MiSaKa100039/Ebike_Motor_Driver/doc/微信图片_2025-11-17_170304_445.png

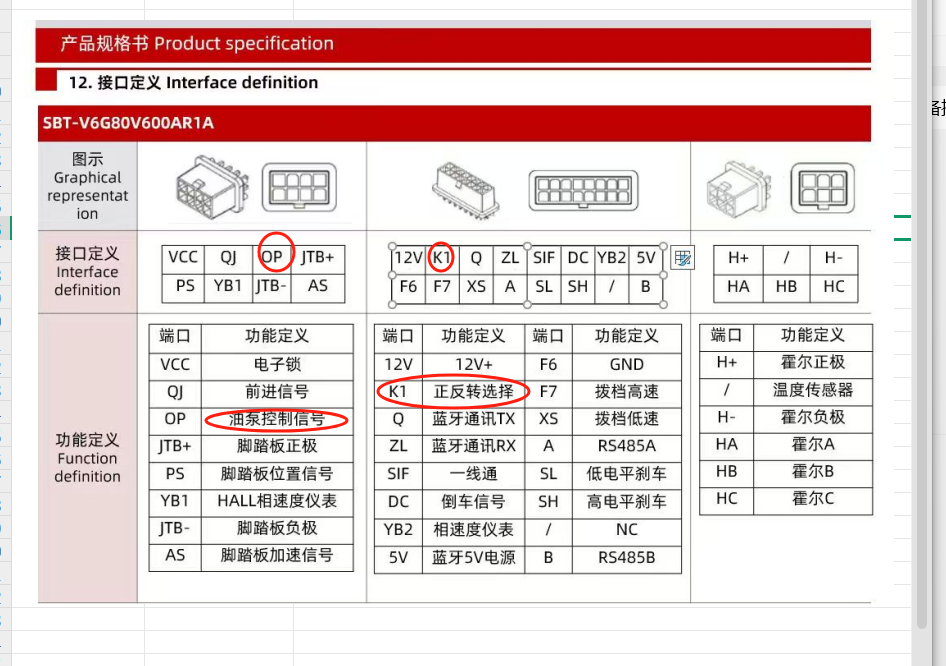
doc/微信图片_2025-11-17_170304_445.png
