MiSaKa100039/Ebike_Motor_Driver/pcb/ControllorBoard/ver0.1/ControllorBoardVer0.1/Project Outputs for ControllorBoardVer0.1/ControllorBoardVer0.1.xlsx

Comment | Description | Designator | Footprint | LibRef | Quantity
100nF 100V | 独石电容 | C1 | C0603_l | C-MLCC | 1
1nF 100V | 独石电容 | C2 | C0603_l | C-MLCC | 1
22uF 35V | 独石电容 | C3, C4 | C1206_L | C-MLCC | 2
4.7uF 35V | 独石电容 | C5 | C0603_l | C-MLCC | 1
100nF 35V | 独石电容, 无极性贴片电容 | C6, C29, C30, C33 | C0603_l | C-MLCC, C | 4
3.3nF 100V | 独石电容 | C7 | C0603_l | C-MLCC | 1
4.7uF 16V | 独石电容 | C8, C9, C19, C22 | C0603_l | C-MLCC | 4
100nF/25V | 无极性贴片电容 | C10 | c0603_l | C | 1
10uF/25V | 无极性贴片电容 | C11, C12 | C1206_l | C | 2
100nF 16V DNP | 独石电容 | C14, C41, C42, C49 | C0603_L | C-MLCC | 4
22uF/16V | 无极性贴片电容 | C15, C16 | C1206_l | C | 2
4.7uF/16V | 无极性贴片电容 | C17 | c0603_l | C | 1
100nF/16V | 无极性贴片电容 | C18, C? | c0603_l | C | 2
68pF/25V | 无极性贴片电容 | C20 | c0603_l | C | 1
560pF/25V | 无极性贴片电容 | C21 | c0603_l | C | 1
Capacitor | 无极性贴片电容 | C23, C24 | c0603_l | C | 2
10uF 35V | 无极性贴片电容 | C25, C26, C27, C28, C31, C32 | C1206_l | C | 6
1nF 6.3V | 独石电容 | C34, C35, C36, C37, C38, C39, C40 | C0603_L | C-MLCC | 7
100nF 6.3V | 独石电容 | C43, C44, C45, C46, C48 | C0603_L | C-MLCC | 5
4.7uF 6.3V | 独石电容 | C47 | C0603_L | C-MLCC | 1
FR107 | 快恢复整流二极管 | D1, D2, D7 | SOD-123 | FR107 | 3
1N4148 | 高速开关二极管 | D3, D4, D5, D6, D8, D9 | SOD-323 | 1N4148 | 6
BZT52C3V3S | 高速开关二极管 | D? | SOD-323 | 1N4148 | 1
10uF 100V | 贴片钽电容 | E1 | CT 6*4 - V | C-CD | 1
M3螺纹孔 |  | Hole1, Hole2, Hole6, Hole7 | M3_3*7载流孔_铜柱 | M3螺纹孔 | 4
M3螺纹孔 |  | Hole3, Hole4, Hole5 | M3_3*7载流孔_螺丝 | M3螺纹孔 | 3
XT150母座夹板 | XT150母座夹板 | J1 | XT150_母座夹板 - VBUS | XT150母座夹板 | 1
XT150母座夹板 | XT150母座夹板 | J2 | XT150_母座夹板 - PGND | XT150母座夹板 | 1
XT150母座夹板 | XT150母座夹板 | J3 | XT150_母座夹板 - duplicate | XT150母座夹板 | 1
XT150母座夹板 | XT150母座夹板 | J4, J5 | XT150_母座夹板 | XT150母座夹板 | 2
HDR-1X8 | 8P接插件 | JP1, JP2, JP3 | 贴片排母2.54mm_交错_8P | Header 8 | 3
HDR-1X4 | 4P接插件 | JP4 | MX 1.25-WS-4P | Header 4 | 1
HDR-1X6 | 6P接插件 | JP5 | MX 1.25-WS-6P | Header 6 | 1
HDR-1X8 | 8P接插件 | JP6 | MX 1.25-WS-8P | Header 8 | 1
33uH | 小功率贴片电感 | L1 | NR6028 | L | 1
8.2uH | 小功率贴片电感 | L2 | NR4020 | L | 1
500R@100MHz | 磁珠 | LB1 | FB 0805_L | LB | 1
TLV9064 RUC | 4路运放 14 引脚 X2QFN | OPA1 | TLV9064 RUC | TLV9064 RUC | 1
TLV9061 DPW | TLV9061 DPW单路运放 | OPA2 | X2SON-4_L0.8-W0.8-P0.48-TL-DPW | TLV9061 DPW | 1
90K 1% | 贴片电阻 | R1 | r0603_l | R | 1
60K 1% | 贴片电阻 | R2, R41, R46, R51, R56 | r0603_l | R | 5
100K 1% | 贴片电阻 | R3, R4, R10 | r0603_l | R | 3
10K 1% | 贴片电阻 | R5, R6, R17, R18, R27, R28, R32, R37, R63, R64 | r0603_l | R | 10
10R 1% | 贴片电阻 | R7, R14, R15, R16, R31, R61 | R0603_l | R | 6
1K 1% | 贴片电阻 | R8, R11, R12, R40, R42, R45, R47, R50, R52, R55, R57 | r0603_l | R | 11
18.7K 1% | 贴片电阻 | R9 | r0603_l | R | 1
19.1K 1% | 贴片电阻 | R13 | r0603_l | R | 1
100R 1% | 贴片电阻 | R19, R20, R25, R26, R33, R36 | r0603_l | R | 6
0R 1% | 贴片电阻 | R21, R22, R23, R24, R29, R30, R34, R35, R38, R65 | r0603_l | R | 10
20K 1% | 贴片电阻 | R39, R43, R44, R48, R49, R53, R54, R58, R59, R60 | R0603_l | R | 10
120R 1% | 贴片电阻 | R62 | R0603_l | R | 1
TP132C33D4_X2SON | 与SOT-23-5符号不同！！！！！ | U1 | ZQFN-4L_L1.0-W1.0-P0.63-BL-EP | TP132C33D4_X2SON | 1
TPS54335A-QFN | BUCK | U2 | VSON-10_L3.0-W3.0-P0.50-TL-EP | TPS54335A-QFN | 1
LP5907_X2SON | 与SOT-23-5符号不同！！！！！ | U3 | ZQFN-4L_L1.0-W1.0-P0.63-BL-EP | LP5907_X2SON | 1
STM32G431CBUx | STM32G431CBUx | U4 | QFN48 7X7_M | STM32G431CBUx | 1
KP521001 | DCDC降压芯片 最大电压100V 最大电流1A | U5 | ESOP8_N | KP521001 | 1
EG3113 | 栅极驱动 | U6, U7, U8 | SOP-8 | EG3113 | 3
SIT3088E | RS485/RS422收发器 | U9 | DFN-8_L3.0-W3.0-P0.65-BL-EP | SIT3088E | 1
8Mhz |  | Y1 | OSC 3225-4P | Crystal | 1
