MiSaKa100039/Ebike_Motor_Driver/pcb/CapacitorBoard/ver0.1/CapacitorBoardVer0.1/STEP/CapacitorBoardVer0.1.step

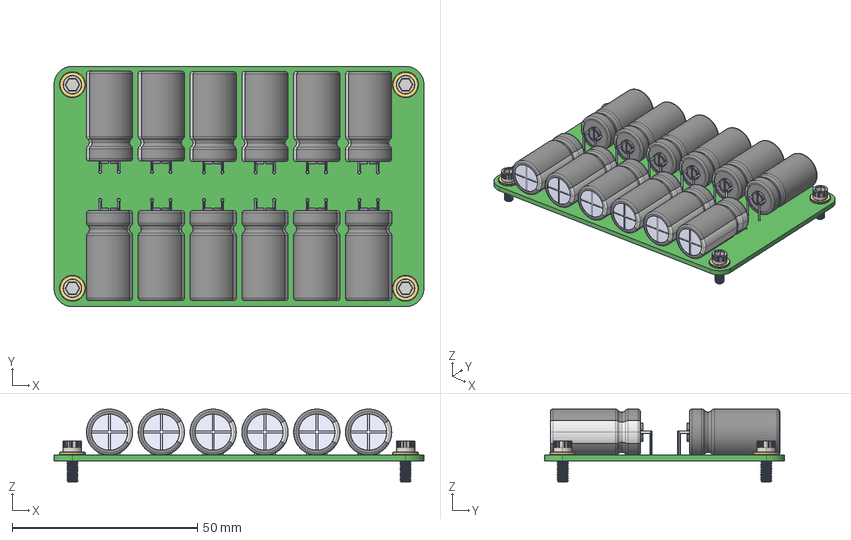
[picture p8: CAD file, 2025-10-23]
pcb/CapacitorBoard/ver0.1/CapacitorBoardVer0.1/STEP/CapacitorBoardVer0.1.step
100.0 x 65.0 x 19.7 mm
ECA-2AM331B x 12
ͭµ熬 x 4
PCI3-8 x 4
