MiSaKa100039/Ebike_Motor_Driver/pcb/ControllorBoard/ver0.2/ControllorBoardVer0.2/STEP/ControllorBoardVer0.1.step

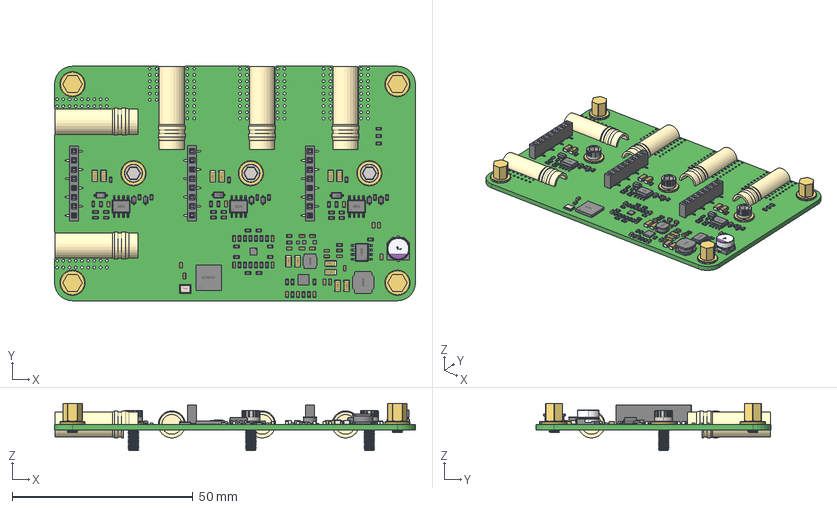
[picture p9: CAD file, 2025-11-03]
pcb/ControllorBoard/ver0.2/ControllorBoardVer0.2/STEP/ControllorBoardVer0.1.step
100.0 x 65.0 x 13.0 mm
_7_1_AF0_1 x 61
Capacitor x 26
TLV9064IRUCR
XT150 female pin x 5
SOP8_00_1_AF0 x 3
ESOP8 ̜ͥ
ºñ¶È1.5 µÄÒý½Å x 8
LOGOԲ0.1
ͭµ熬 x 7
m3ͭµ¥ͨ5mm x 4
PCI3-8 x 3
OSC 3225-4
LOGOԲ0.15
QFN48-7X7 ̜ͥ
QFN48 ӽ½À x 168
LOGOԲ0.75 x 2
VSON-10_L3.0-W3.0-P0.50-TL-EP~VSON-10_L3.0-W3.0-H0.6-P0.50~aweX
NR4020
LOGOԲ0.5
NR6028
HDR-SMD_8P-P2.54-V-F-LS4.9~HDR-SMD_8P-P2.54-V-F-LS4.9~xS7p x 3
LOGOԲ
CT 6X4-V
SOD-323 x 6
LOGOԲ££°.£³ x 9
SOD-123 x 3
Capacitor_331281722 x 12
