MiSaKa100039/Ebike_Motor_Driver/pcb/PowerBoard/OutLIne.DXF

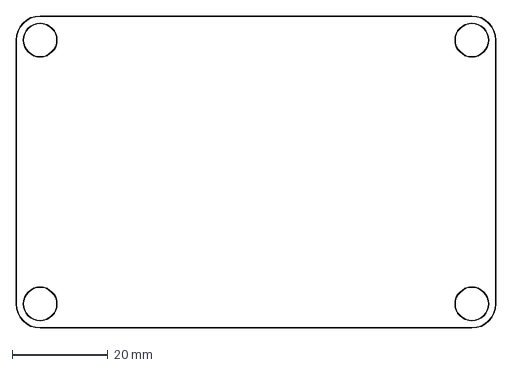
[picture p10: CAD file, 2025-10-21]
pcb/PowerBoard/OutLIne.DXF
100.0 x 65.0 mm
