MiSaKa100039/Ebike_Motor_Driver/pcb/PowerBoard/ver0.1/PowerBoardver0.1/STEP/PowerBoardver0.1.step

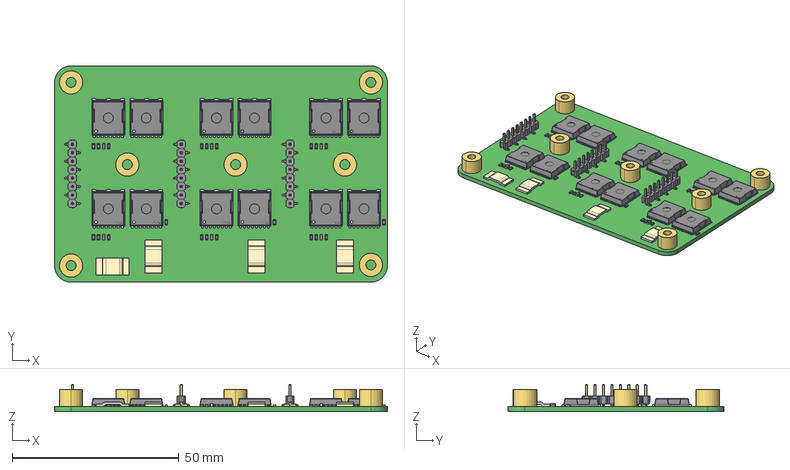
[picture p11: CAD file, 2025-10-23]
pcb/PowerBoard/ver0.1/PowerBoardver0.1/STEP/PowerBoardver0.1.step
100.0 x 65.0 x 8.18 mm
TOLL-8_L10.4-W9.9-P1.20-LS11.7-BL_2~TOLL-8_L10.4-W9.9-P1.20-LS11.7-BL_ 2~LBb8 x 12
M3x7x5 x 7
R3920~R3920~LBb8 x 4
_7_1_AF0_1 x 21
HDR-SMD_8P-P2.54-V-M-LS4.8_R2~1x8p 2.54mm______ x 3
Capacitor x 6
