MiSaKa100039/Ebike_Motor_Driver/(list of files, cad)

Other CAD files:
pcb/CapacitorBoard/ver0.1/CapacitorBoardVer0.1/STEP/CapacitorBoardVer0.1.SLDASM
pcb/ControllorBoard/ver0.2/ControllorBoardVer0.2/STEP/ControllorBoardVer0.1.SLDASM
