MiSaKa100039/Ebike_Motor_Driver/doc/SCH_K301_2025-11-13.pdf

电源

# MCU

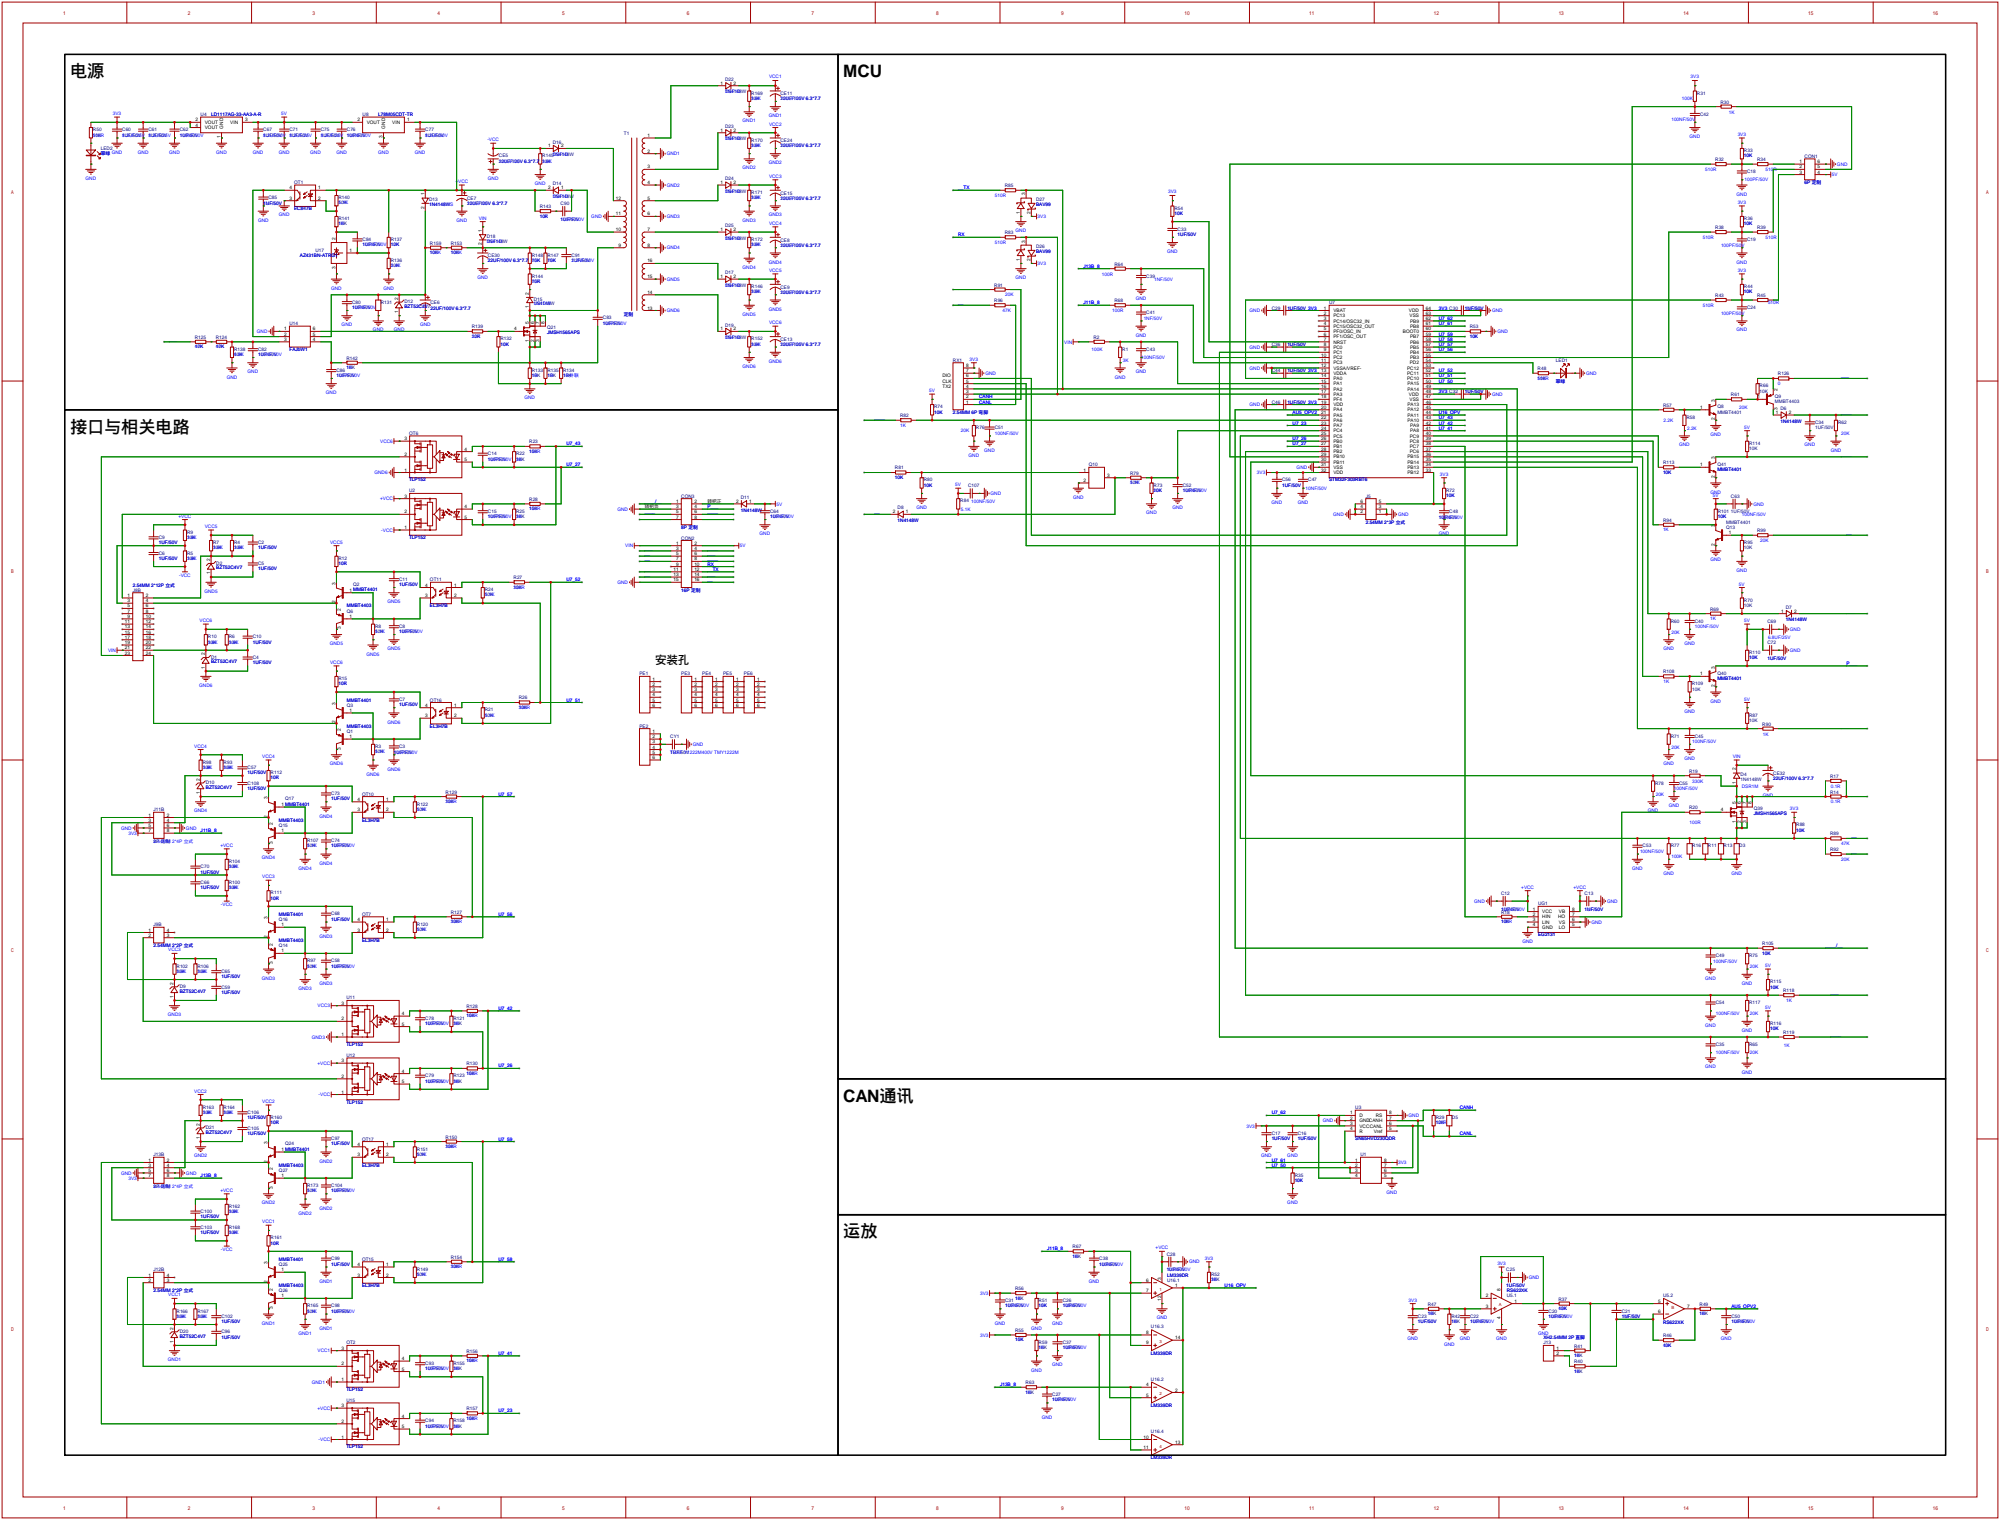
[picture p12: page 1]
