MiSaKa100039/Ebike_Motor_Driver/pcb/PowerBoard/ver0.1/PowerBoardver0.1/PowerBoardver0.1.pdf

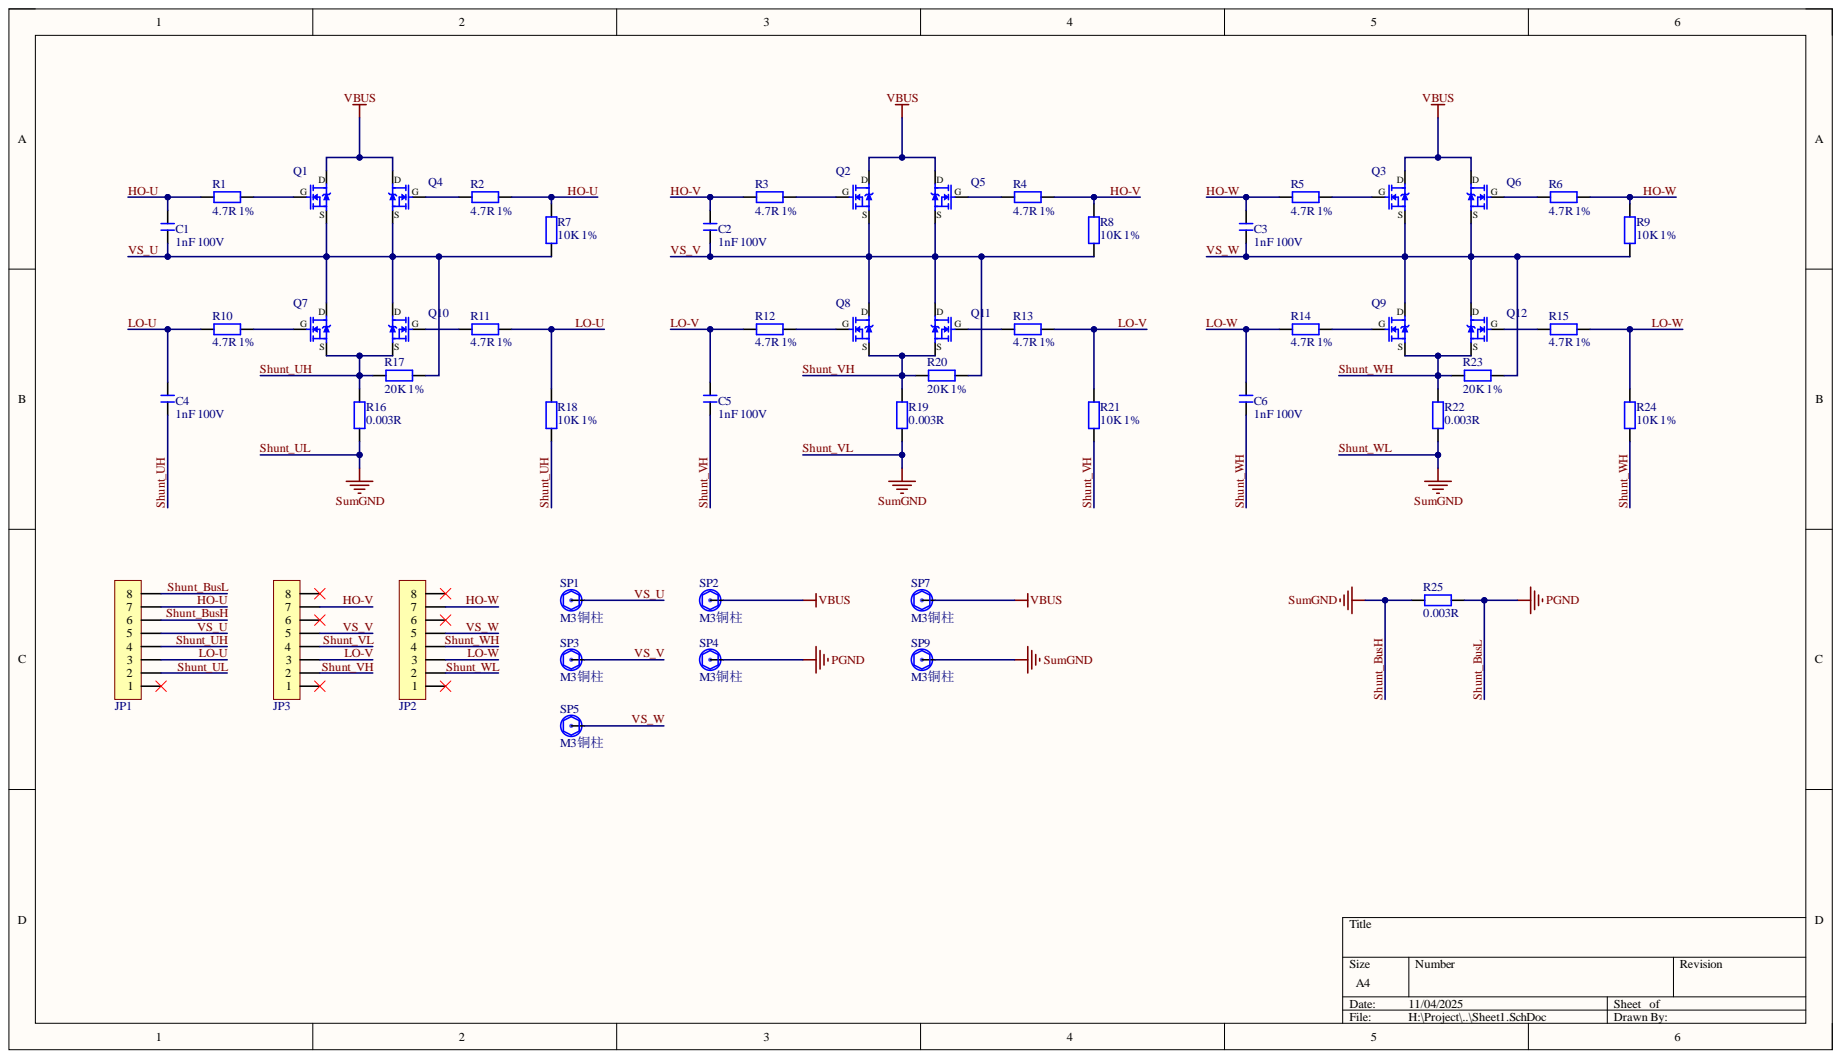
[picture p13: page 1]

Size A4 | Number | Revision

Date: 11/04/2025 | Sheet of
File: H:\Project\..\Sheet1.SchDoc | Drawn By:

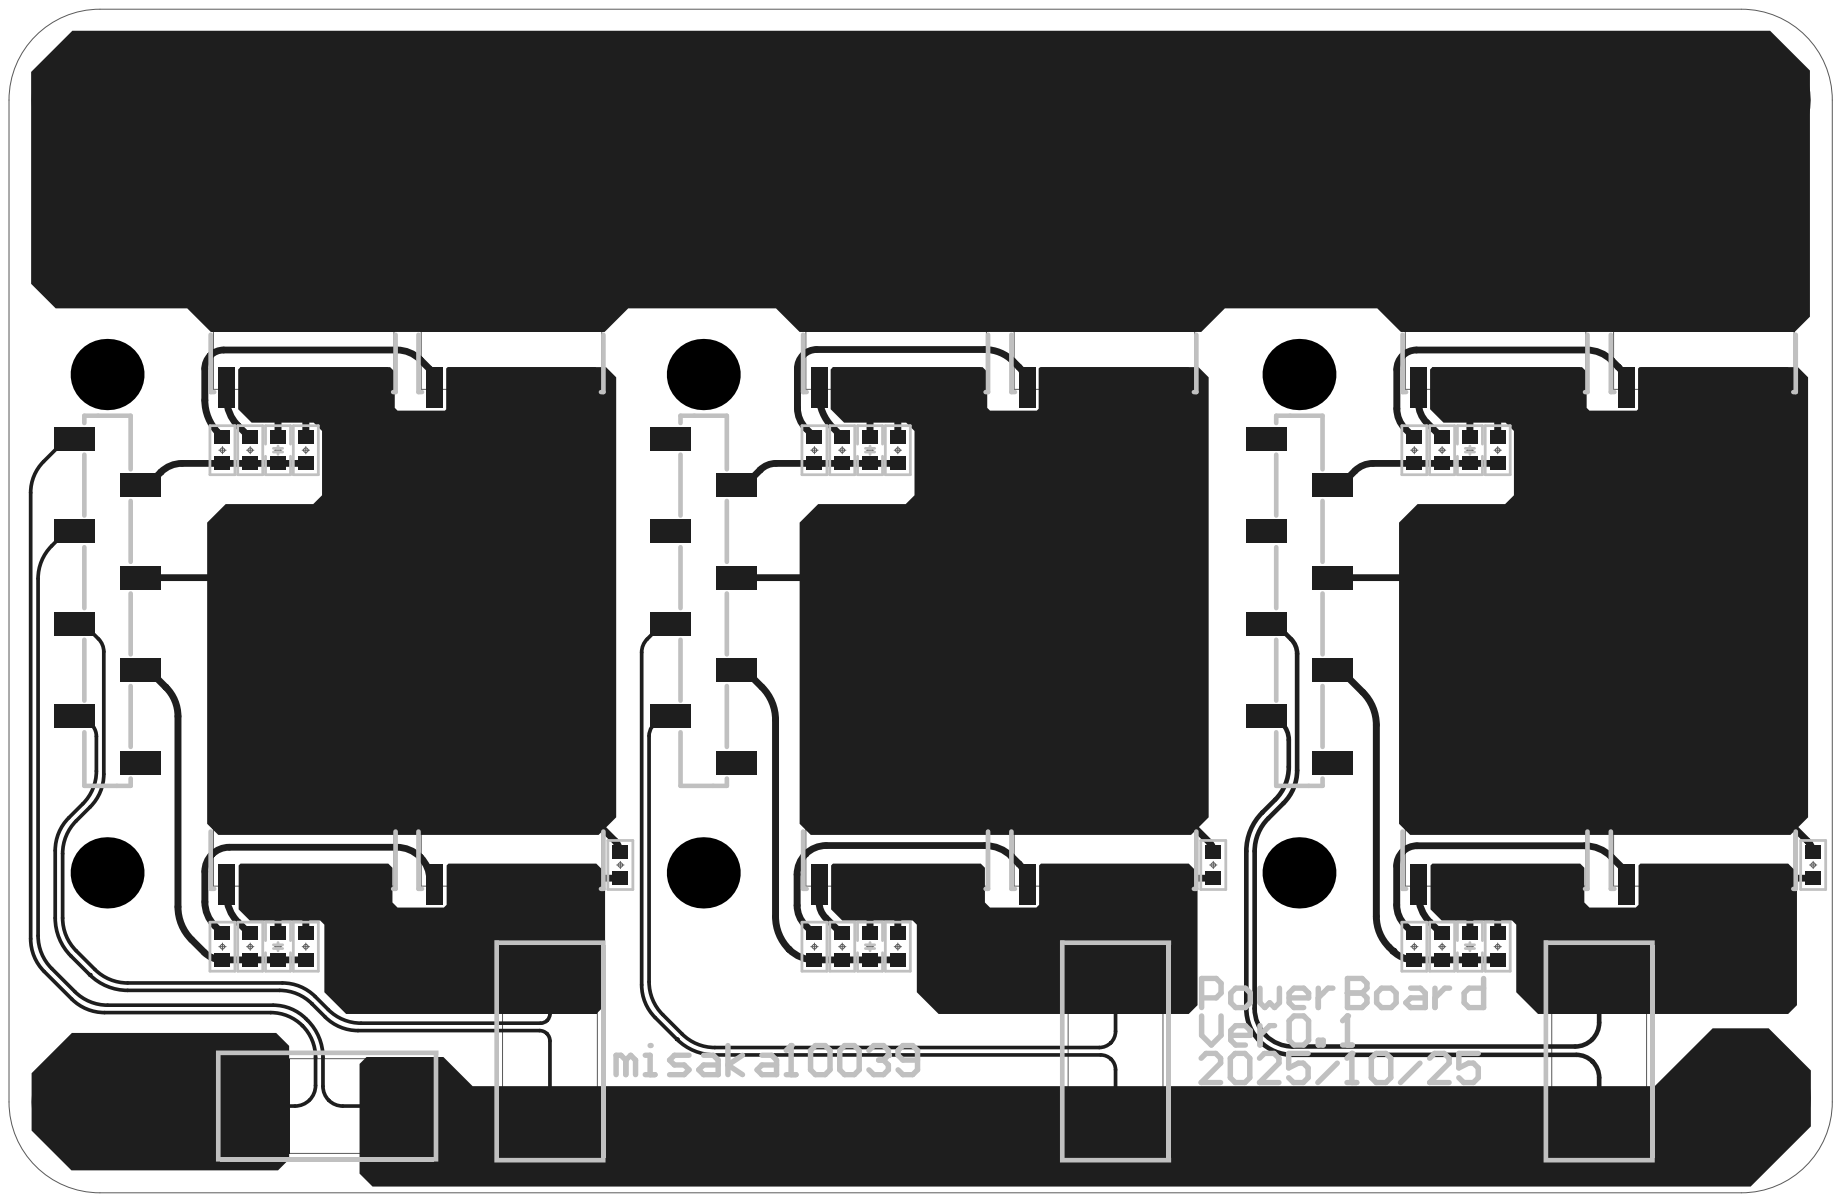
[picture p14: page 2]
