MiSaKa100039/Ebike_Motor_Driver/pcb/ControllorBoard/ver0.1/ControllorBoardVer0.1/ControllorBoardVer0.1.pdf

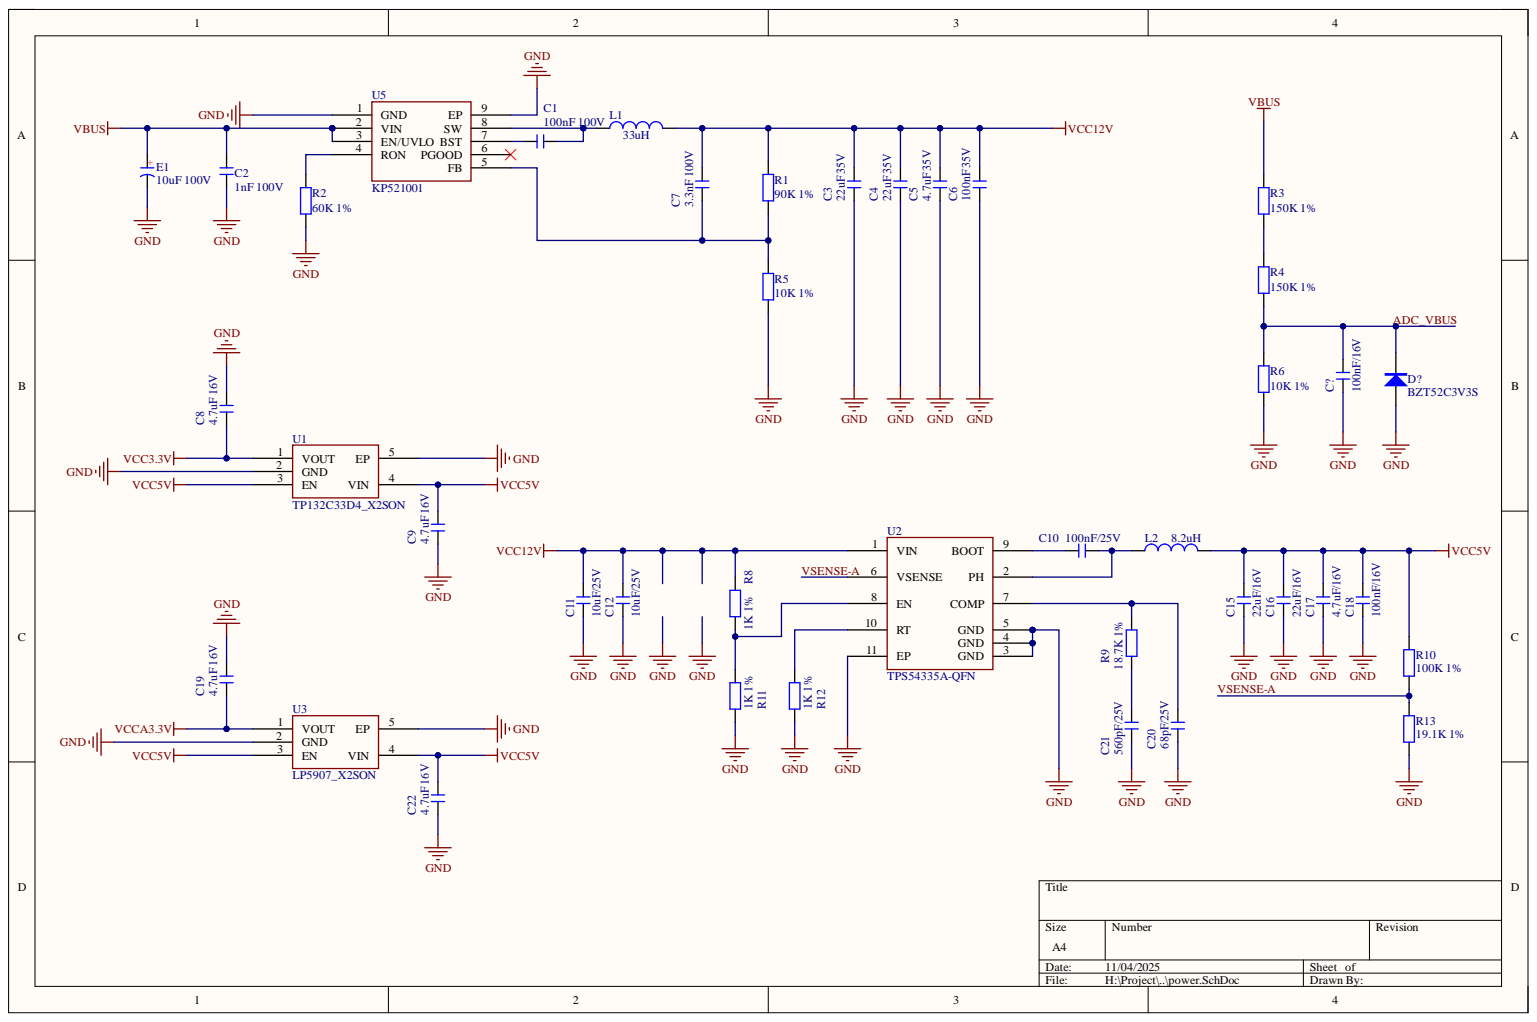
[picture p15: page 1]

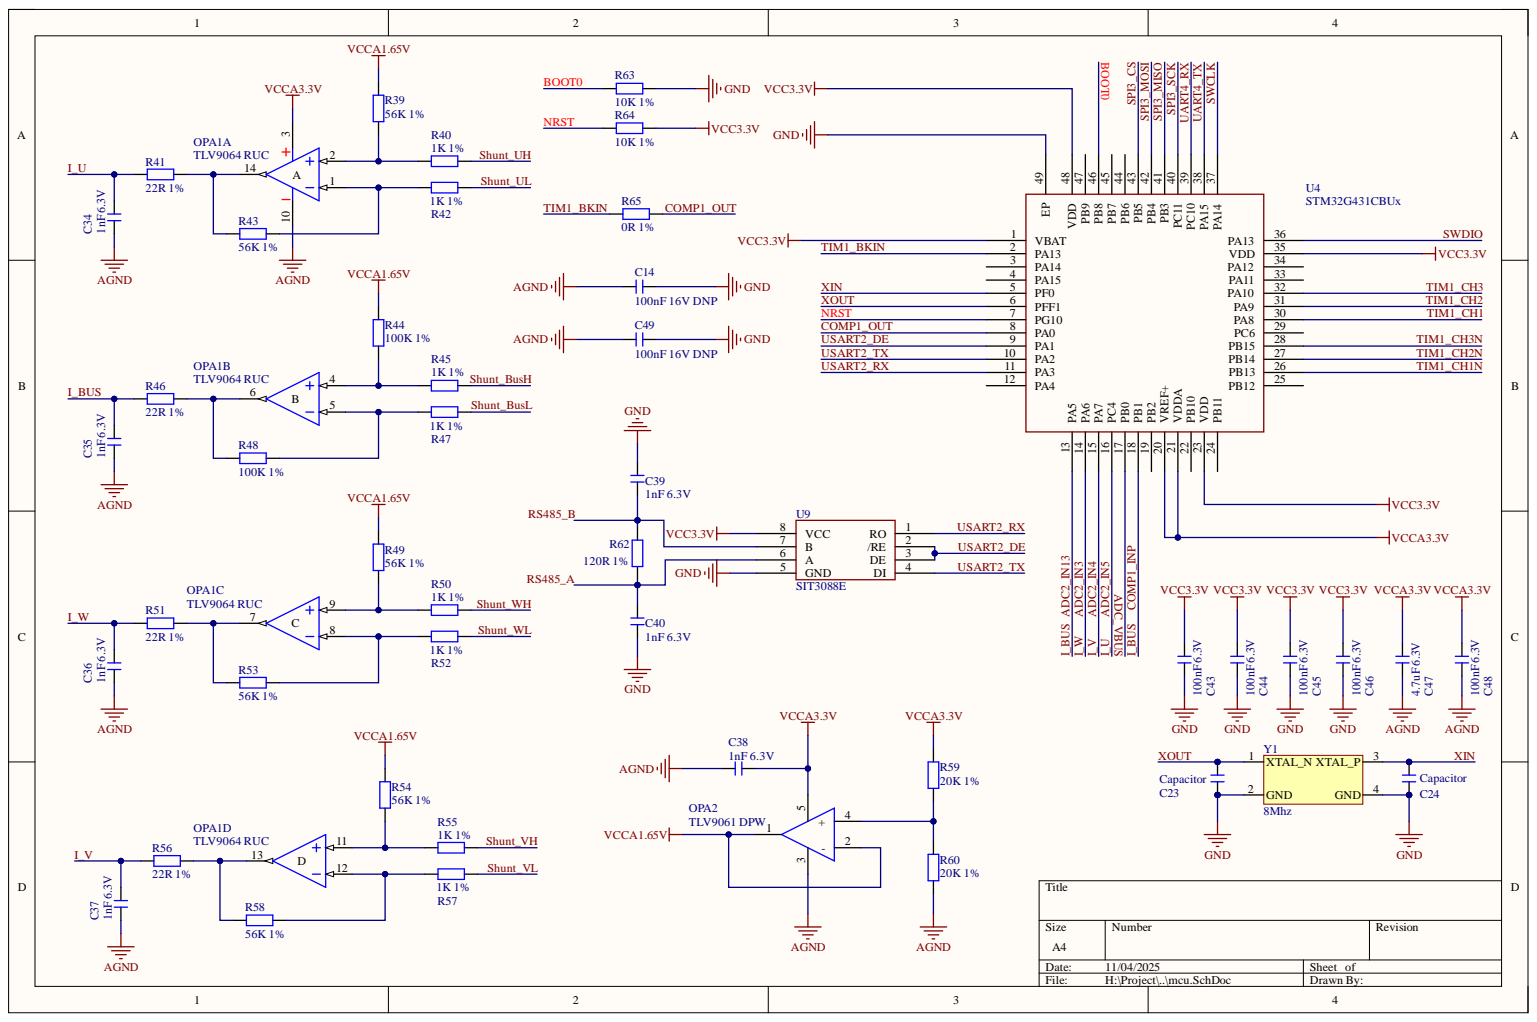
[picture p16: page 2]

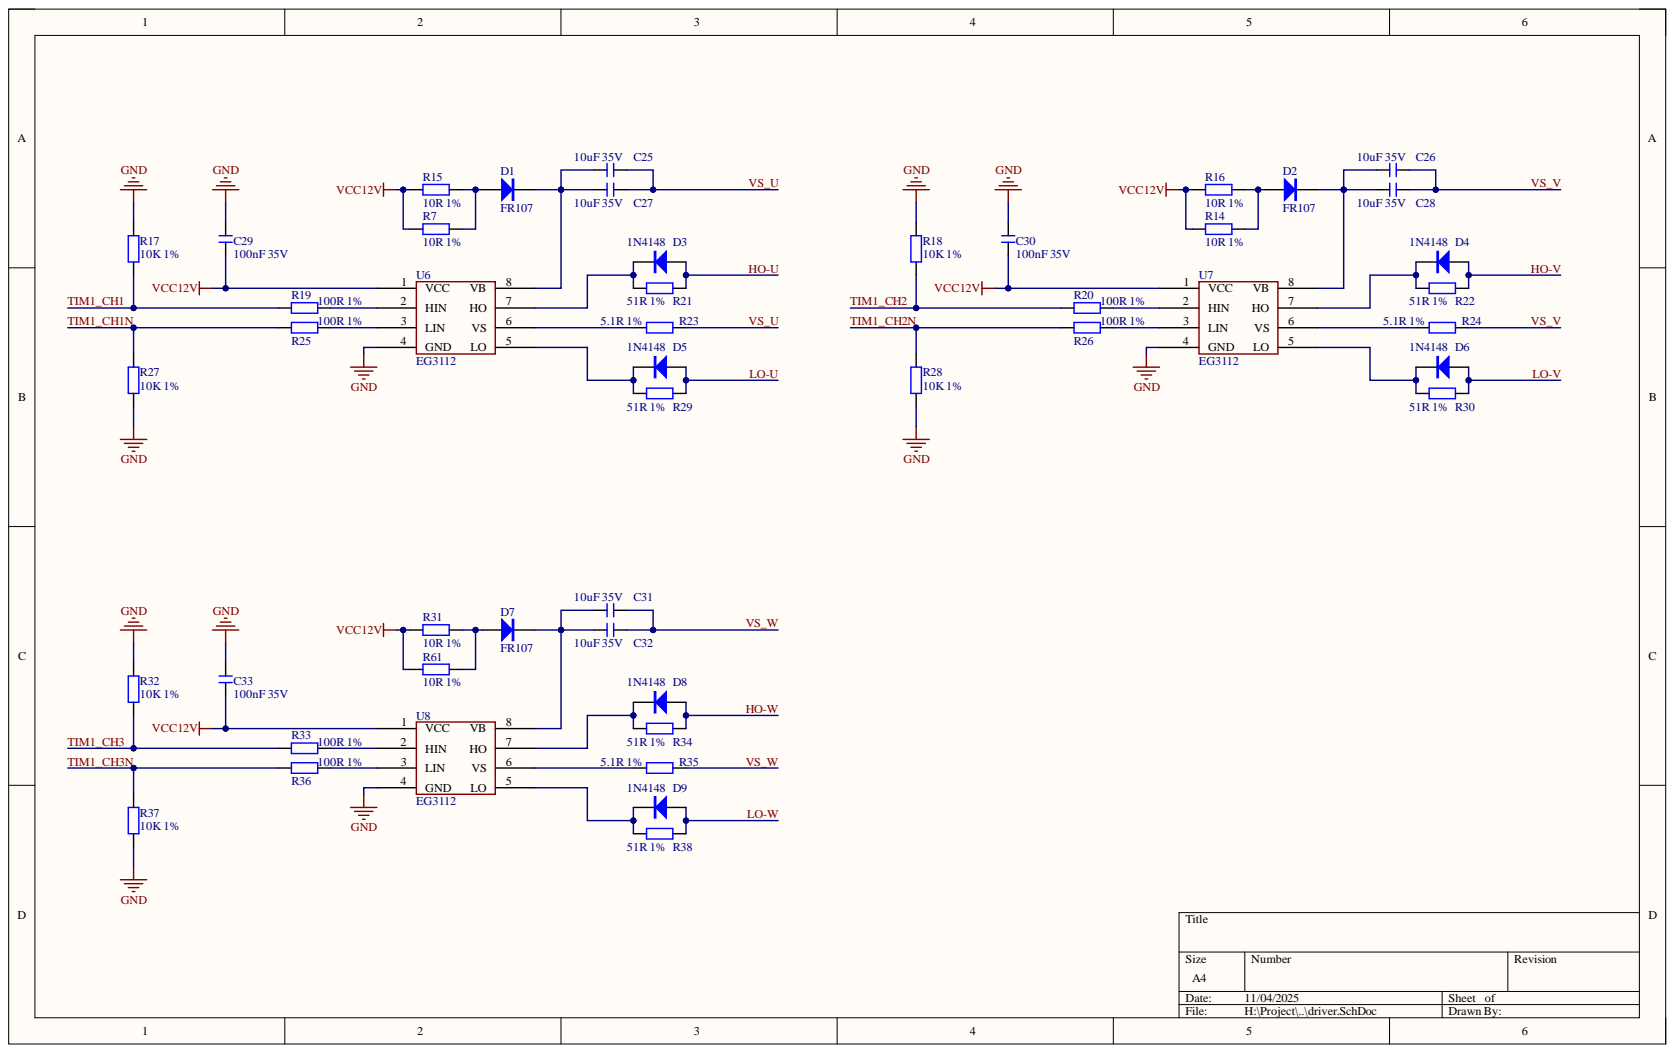
[picture p17: page 3]

Size A4 | Number | Revision

Date: 11/04/2025 | Sheet of
File: H:\Project\..\driver.SchDoc | DrawnBy:

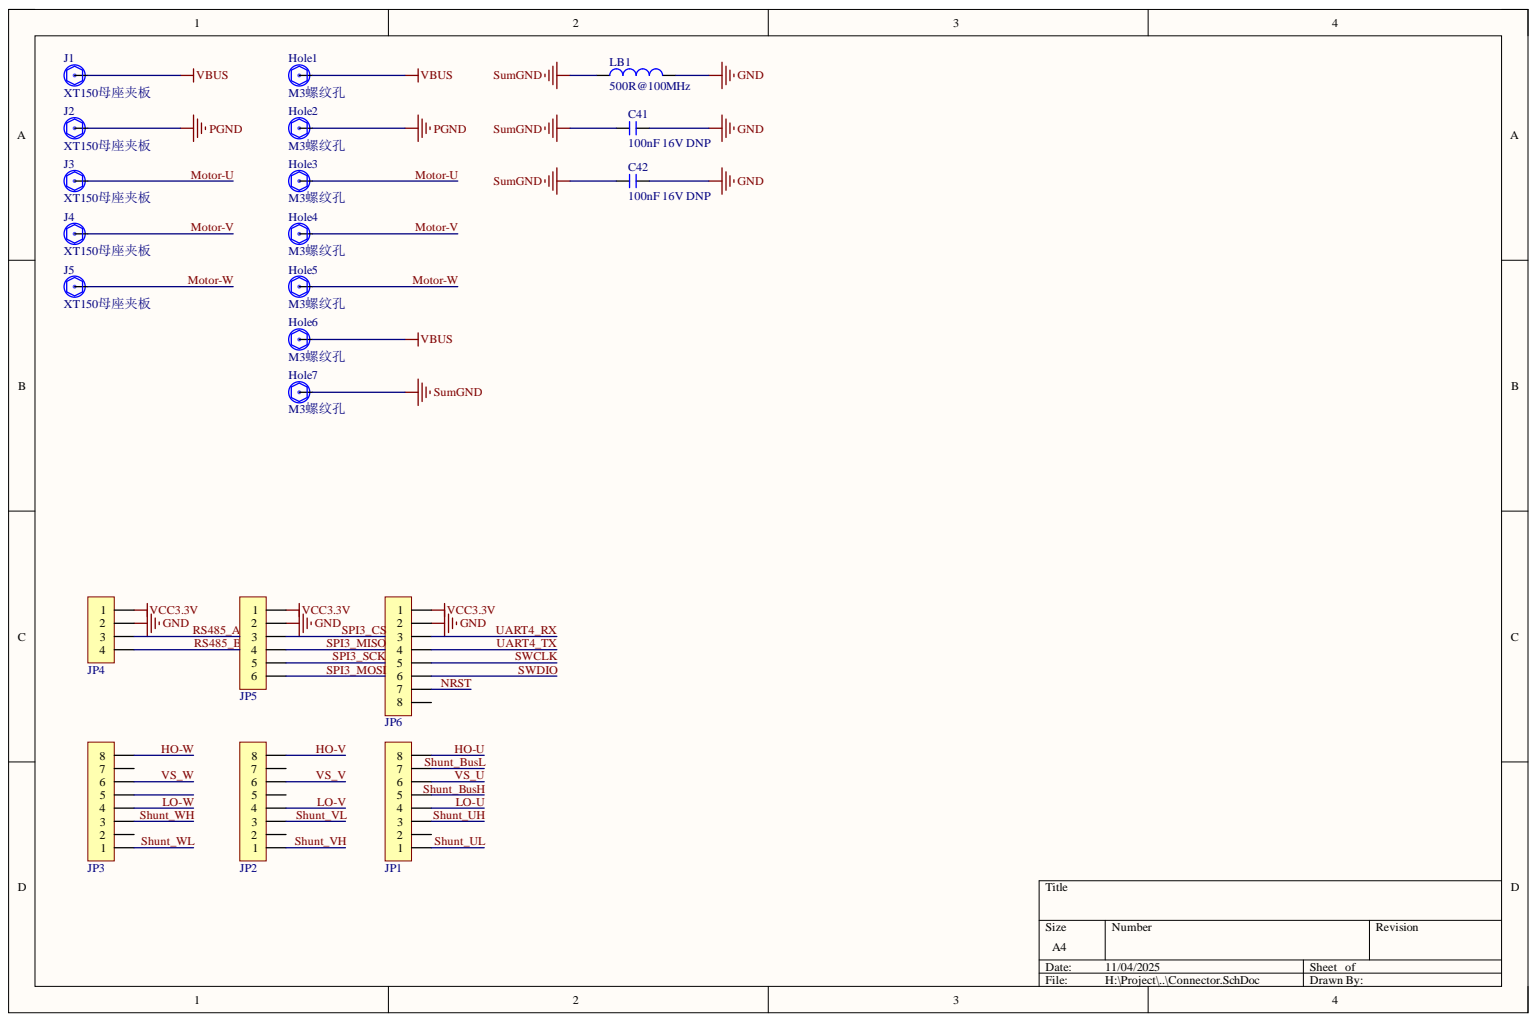
[picture p18: page 4]

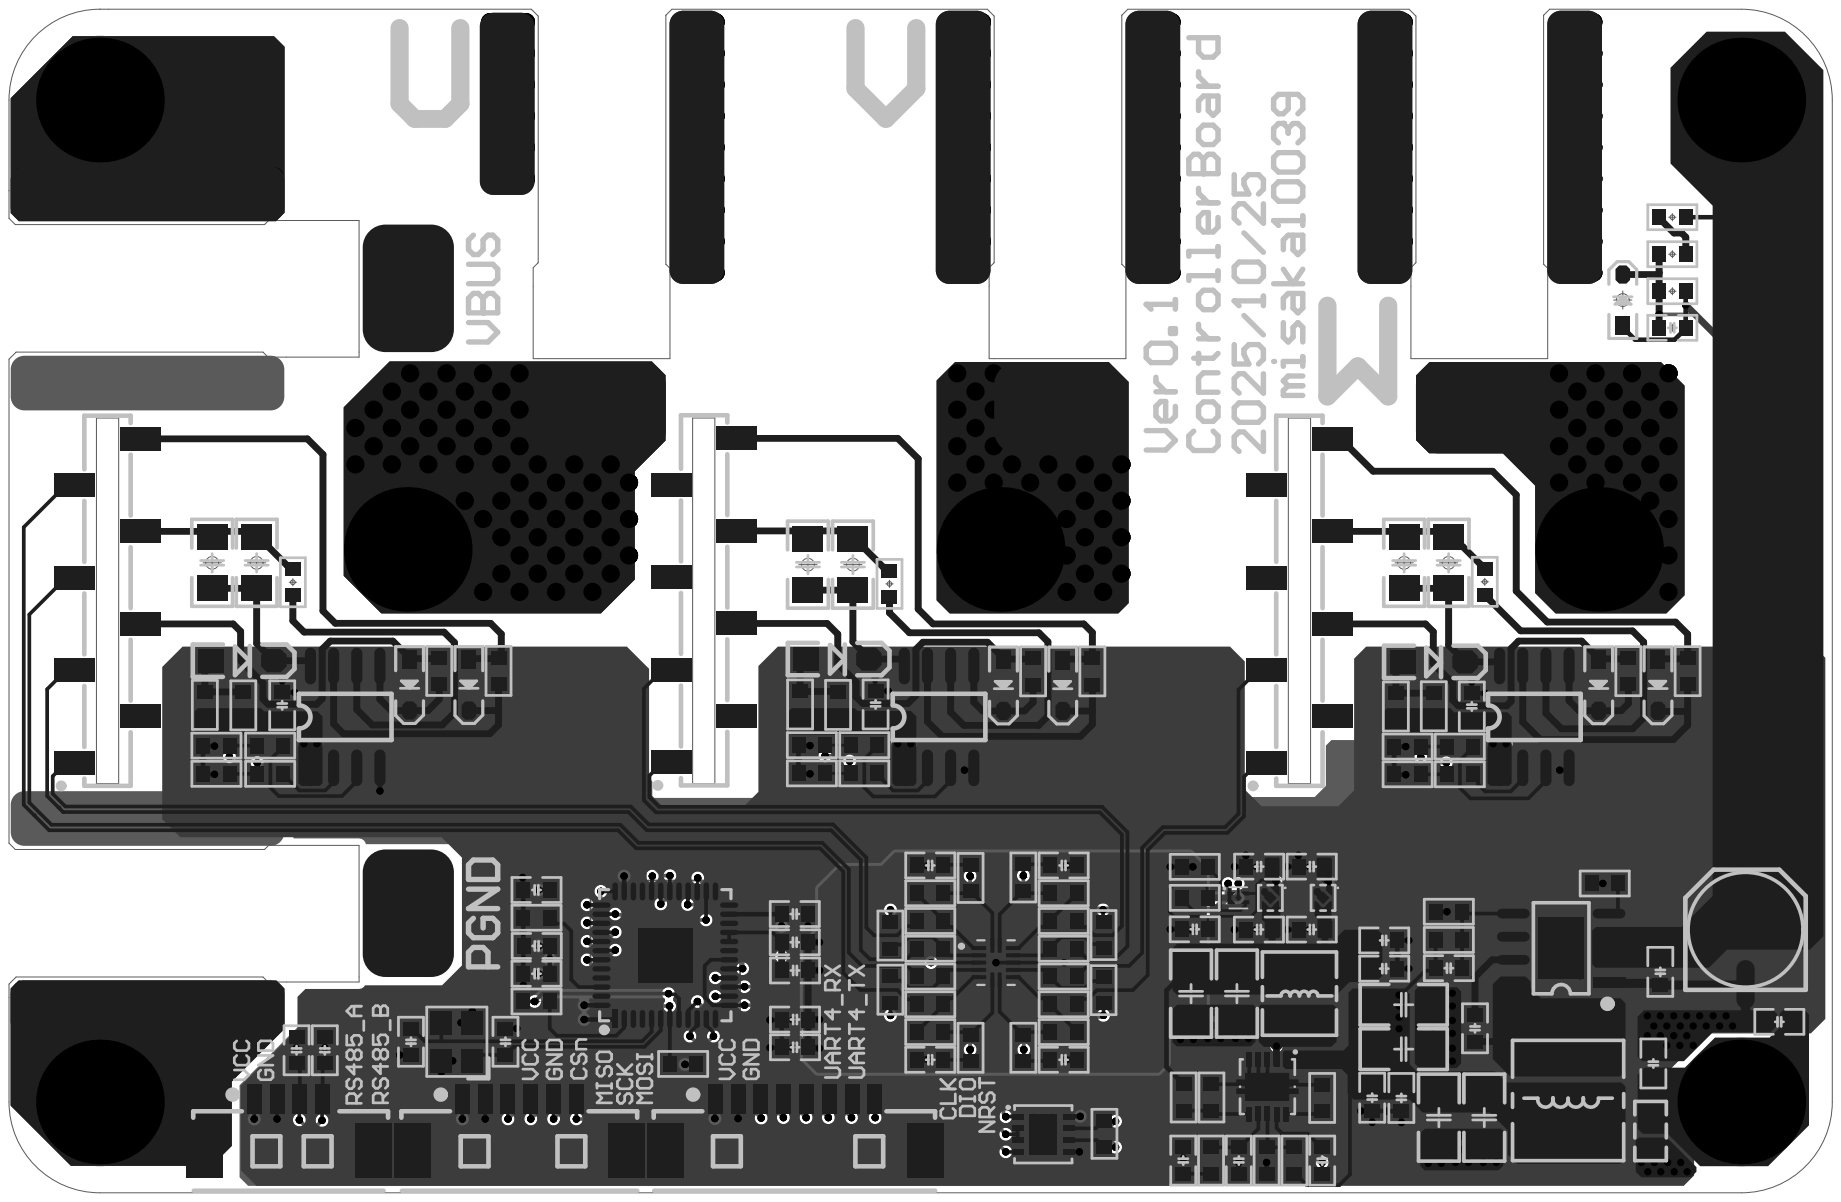
[picture p19: page 5]
