MiSaKa100039/Ebike_Motor_Driver/(list of files, drawings)

Other design files:
pcb/CapacitorBoard/ver0.1/CapacitorBoardVer0.1/CapacitorBoardVer0.1.PrjPcb
pcb/CapacitorBoard/ver0.1/CapacitorBoardVer0.1/PCB1.PcbDoc
pcb/CapacitorBoard/ver0.1/CapacitorBoardVer0.1/Sheet.SchDoc
pcb/ControllorBoard/ver0.1/ControllorBoardVer0.1/Connector.SchDoc
pcb/ControllorBoard/ver0.1/ControllorBoardVer0.1/ControllorBoardVer0.1.PrjPcb
pcb/ControllorBoard/ver0.1/ControllorBoardVer0.1/driver.SchDoc
pcb/ControllorBoard/ver0.1/ControllorBoardVer0.1/mcu.SchDoc
pcb/ControllorBoard/ver0.1/ControllorBoardVer0.1/PCB.PcbDoc
pcb/ControllorBoard/ver0.1/ControllorBoardVer0.1/power.SchDoc
pcb/ControllorBoard/ver0.2/ControllorBoardVer0.2/Connector.SchDoc
pcb/ControllorBoard/ver0.2/ControllorBoardVer0.2/ControllorBoardVer0.2.PrjPcb
pcb/ControllorBoard/ver0.2/ControllorBoardVer0.2/driver.SchDoc
pcb/ControllorBoard/ver0.2/ControllorBoardVer0.2/mcu.SchDoc
pcb/ControllorBoard/ver0.2/ControllorBoardVer0.2/PCB.PcbDoc
pcb/ControllorBoard/ver0.2/ControllorBoardVer0.2/power.SchDoc
pcb/PowerBoard/ver0.1/PowerBoardver0.1/PCB1.PcbDoc
pcb/PowerBoard/ver0.1/PowerBoardver0.1/PowerBoardver0.1.PrjPcb
pcb/PowerBoard/ver0.1/PowerBoardver0.1/Sheet1.SchDoc
