MiSaKa100039/Ebike_Motor_Driver/code/Ebike_Motor_Driver_Demo1/EbikeDriver-Demo1.ioc

Mcu.UserName=STM32G431CBUx
PA10.Signal=S_TIM1_CH3
PA13.Signal=SYS_JTMS-SWDIO
PA14.Signal=SYS_JTCK-SWCLK
PA5.GPIO_Label=I-BUS
PA5.Signal=ADC2_IN13
PA6.GPIO_Label=I-W
PA6.Signal=ADC2_IN3
PA7.GPIO_Label=I-V
PA7.Signal=ADC2_IN4
PA8.Signal=S_TIM1_CH1
PA9.Signal=S_TIM1_CH2
PB0.GPIO_Label=V-BUS
PB0.Signal=ADC1_IN15
PB13.Signal=TIM1_CH1N
PB14.Signal=TIM1_CH2N
PB15.Signal=TIM1_CH3N
PC10.Signal=UART4_TX
PC11.Signal=UART4_RX
PC13.Signal=GPIO_Output
PC4.GPIO_Label=I-U
PC4.Signal=ADC2_IN5
PF0-OSC_IN.Signal=RCC_OSC_IN
PF1-OSC_OUT.Signal=RCC_OSC_OUT
