MiSaKa100039/Ebike_Motor_Driver/code/Ebike_Motor_Driver_Demo1/Core/Inc/main.h

#define I_BUS_Pin GPIO_PIN_5
#define I_BUS_GPIO_Port GPIOA
#define I_W_Pin GPIO_PIN_6
#define I_W_GPIO_Port GPIOA
#define I_V_Pin GPIO_PIN_7
#define I_V_GPIO_Port GPIOA
#define I_U_Pin GPIO_PIN_4
#define I_U_GPIO_Port GPIOC
#define V_BUS_Pin GPIO_PIN_0
#define V_BUS_GPIO_Port GPIOB
