MiSaKa100039/Ebike_Motor_Driver/(commit log)

2025-10-21 控制器---->功率板over ---->控制板原理图
    [CapacitorBoardVer0.1.PrjPcb, ControllorBoardVer0.1.PrjPcb, OutLIne.DXF, PCB1.PcbDoc, PowerBoardver0.1.PrjPcb, Sheet.SchDoc, Sheet1.SchDoc, driver.SchDoc]
2025-10-22 控制板原理图
    [CapacitorBoardVer0.1.PrjPcb, Connector.SchDoc, ControllorBoardVer0.1.PrjPcb, PCB1.PcbDoc, PowerBoardver0.1.step, Sheet.SchDoc, driver.SchDoc, mcu.SchDoc]
2025-10-23 电容板 运放
    [CapacitorBoardVer0.1.SLDASM, CapacitorBoardVer0.1.step, Connector.SchDoc, PCB1.PcbDoc, PowerBoardver0.1.step, Sheet.SchDoc, Sheet1.SchDoc, driver.SchDoc]
2025-10-25 Ver0.1打板测试
    [Connector.SchDoc, PCB1.PcbDoc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]
2025-10-27 修改Gerber
    [ControllorBoardVer0.1.xlsx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]
2025-11-03 Ver0.2打板测试
    [CapacitorBoardVer0.1.PrjPcb, Connector.SchDoc, ControllorBoardVer0.1.SLDASM, ControllorBoardVer0.1.step, ControllorBoardVer0.2.PrjPcb, PCB.PcbDoc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]
2025-11-12 修改原理图库
    [mcu.SchDoc]
2026-01-07 1.修改测试代码
    [daplink.cfg, mcu.SchDoc, stlink.cfg]
