MiSaKa100039/Ebike_Motor_Driver/(notices)

Notices in the files:
code/Ebike_Motor_Driver_Demo1/Core/Inc/main.h:
Copyright (c) 2026 STMicroelectronics.
All rights reserved.
This software is licensed under terms that can be found in the LICENSE file
